AntoineGagnon/miryoku_zmk/temper-tps43-interposer/output/schematic.pdf

1 | 2 | 3 | 4 | 5 | 6
1 | 2 | 3 | 4 | 5 | 6

AB

C

D

AB

C

D Date:

Size: A4 | Rev: 1.0
KiCad E.D.A. 10.0.5 | Id: 1/1

### Title: Temper TPS43 Interposer

File: temper-tps43-interposer.kicad_sch

Sheet: /

nice!nano v2 pass-through with Azoteq TPS43 trackpad breakout

Nets: GND VCC SDA SCL RDY RST. All other Pro Micro pins pass through.

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
JP1 Pro Micro L | R2

2.2k R1
2.2k

# Mounting 1

2
3
4
5
6 MP

CON1

FFC 1x06 0.5mm

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
JP2 Pro Micro R | SCL VCC SDA VCC
RST | SDA GND | GND

RDY

VCC

## SDA GND

GND

SCL | SCL RDY

VCC

GND

RST JP1 / JP2 reproduce the nice!nano v2 (Pro Micro) footprint one for one. JP1.11 D8 / P1.04 -> SDA | JP2.12 D10 / P0.11 -> RDY
JP1.3, JP1.4, JP2.2 -> GND | JP2.4 | VCC (3.3V) | -> VCC
JP1.12 D9 / P0.09 -> SCL | JP2.11 D16 / P1.06 -> RST

tied to GND. B.Cu is a GND plane carrying the VCC, SCL-to-R2 and RST crossings.

straight-through cable instead, this board is wrong and must be re-fabbed.

Every pin not listed below is a bare pass-through: plated hole, no copper attached.

1:RDY 2:NRST 3:GND 4:VDDHI 5:SCL 6:SDA, so CON1 pin N carries TPS43 pin 7-N.

CON1 is wired as the MIRROR of the trackpad's own connector, because the FFC cable reverses the conductor order end to end. TPS43 J1 (datasheet rev 1.06, Aug 2025) is

R1/R2 are the 2.2k I2C bus pull-ups. CON1 MP is the pair of mechanical solder tabs,

VERIFY the cable before assembly: ring out pin 1 to pin 6 with a meter. If it is a
