AntoineGagnon/miryoku_zmk/temper-tps43-interposer/output/bottom.png

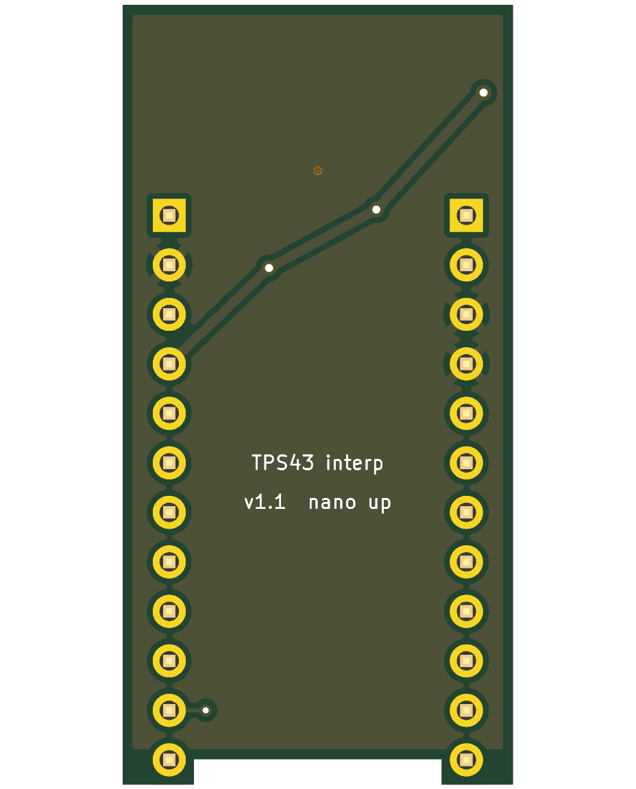
temper-tps43-interposer/output/bottom.png
