AntoineGagnon/miryoku_zmk/temper-tps43-interposer/output/top.png

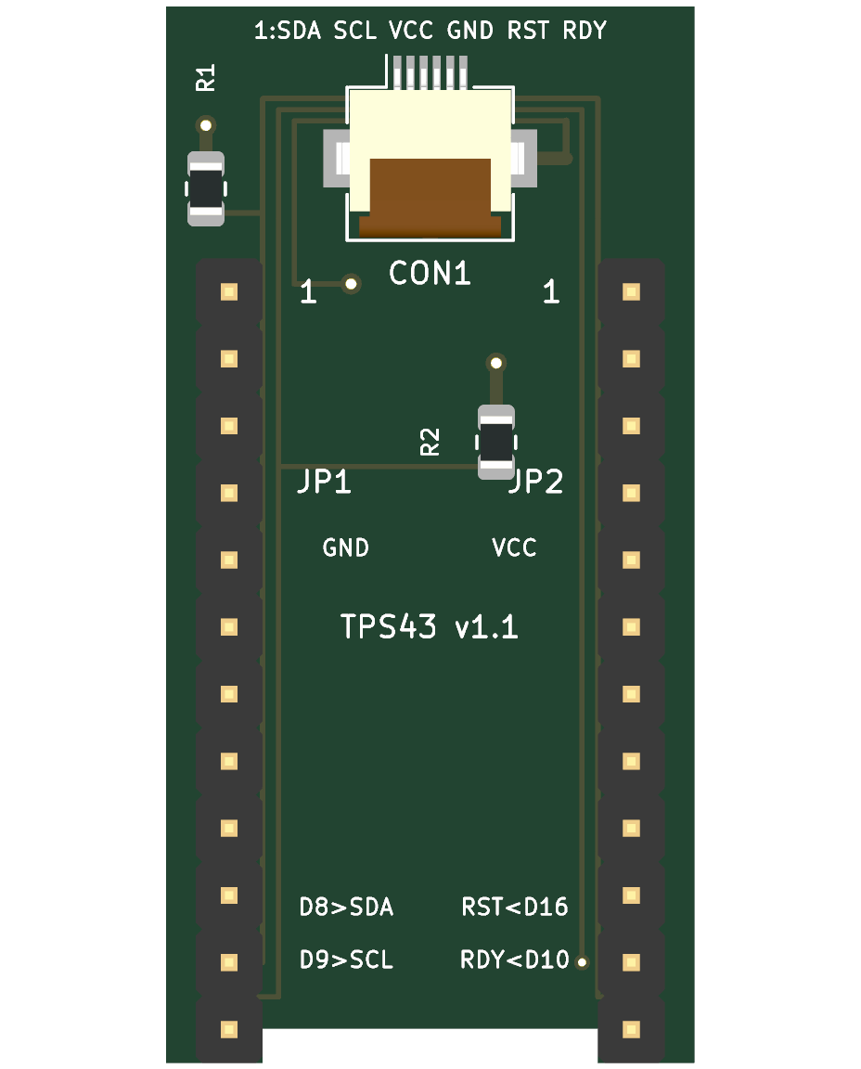
temper-tps43-interposer/output/top.png
