AntoineGagnon/miryoku_zmk/temper-tps43-interposer/temper-tps43-interposer.kicad_pcb

## KiCad design temper-tps43-interposer/temper-tps43-interposer.kicad_pcb (2026-08-06)

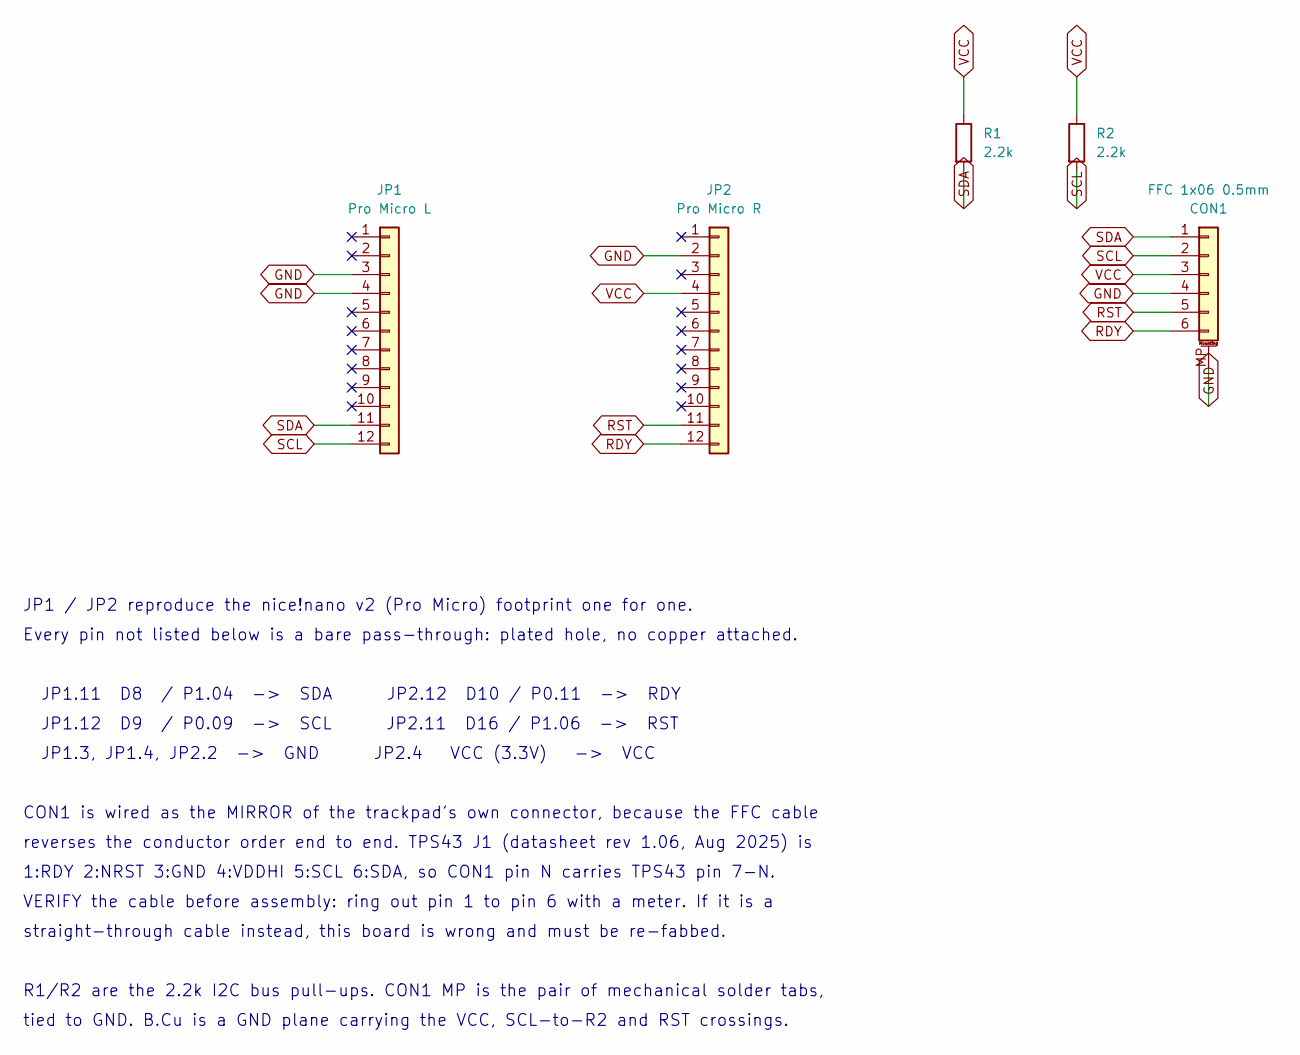
[picture p3: schematic temper-tps43-interposer.kicad_sch, Temper TPS43 Interposer]

Parts:
CON1: FFC 1x06 0.5mm; Hirose_FH12-6S-0.5SH_1x06-1MP_P0.50mm_Horizontal
JP1: Pro Micro L; PinHeader_1x12_P2.54mm_Vertical
JP2: Pro Micro R; PinHeader_1x12_P2.54mm_Vertical
R1, R2: 2.2k; R_0805_2012Metric

Connections:
GND: CON1.4, CON1.MP (MountPin), JP1.3, JP1.4, JP2.2
RDY: CON1.6, JP2.12
RST: CON1.5, JP2.11
SCL: CON1.2, JP1.12, R2.2
SDA: CON1.1, JP1.11, R1.2
VCC: CON1.3, JP2.4, R1.1, R2.1

Notes on the sheet:
JP1.12 D9 / P0.09 -> SCL JP2.11 D16 / P1.06 -> RST
VERIFY the cable before assembly: ring out pin 1 to pin 6 with a meter. If it is a
JP1.3, JP1.4, JP2.2 -> GND JP2.4 VCC (3.3V) -> VCC
R1/R2 are the 2.2k I2C bus pull-ups. CON1 MP is the pair of mechanical solder tabs,
JP1.11 D8 / P1.04 -> SDA JP2.12 D10 / P0.11 -> RDY
JP1 / JP2 reproduce the nice!nano v2 (Pro Micro) footprint one for one.
reverses the conductor order end to end. TPS43 J1 (datasheet rev 1.06, Aug 2025) is
CON1 is wired as the MIRROR of the trackpad's own connector, because the FFC cable
1:RDY 2:NRST 3:GND 4:VDDHI 5:SCL 6:SDA, so CON1 pin N carries TPS43 pin 7-N.
Every pin not listed below is a bare pass-through: plated hole, no copper attached.
straight-through cable instead, this board is wrong and must be re-fabbed.
tied to GND. B.Cu is a GND plane carrying the VCC, SCL-to-R2 and RST crossings.

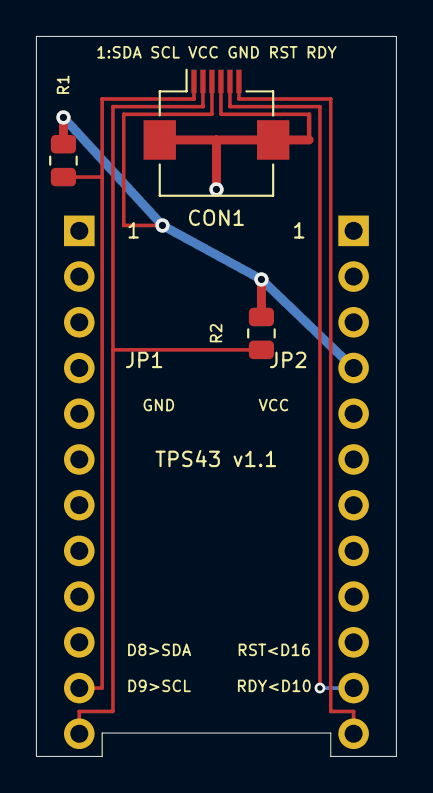
[picture p4: board temper-tps43-interposer.kicad_pcb from above]

Board: 2 copper layers, 20.0 x 40.0 mm, 5 parts (0 on the bottom side), 6 nets.
