AntoineGagnon/miryoku_zmk/(commit log)

2025-10-20 Move config to .github/actions-folders.json
    - Move from .github/workflows/actions-folders.yml to .github/actions-folders.json
    - Prevents GitHub Actions from treating config as workflow
    - Switch from YAML to JSON format for simpler parsing
2026-07-13 fix board name changes
2026-07-13 Fix board id and artifact name for ZMK Zephyr 4.1 board variants
    ZMK's move to Zephyr 4.1 HWMv2 requires an explicit zmk board variant
    (e.g. nice_nano//zmk instead of nice_nano or nice_nano_v2), otherwise
    shield board-overlays like nice_view_adapter's are silently skipped and
    the devicetree build fails on an undefined nice_view_spi label.
    The new board id contains slashes, which are invalid in artifact names,
    so sanitize them the same way spaces already are when building run_name.
2026-07-17 Add TPS43 trackpad interposer PCB for Temper keyboard
    - KiCAD 9 project with schematic and PCB layout
    - Custom footprint for Molex 503480-0600 FFC connector (6-pin, 0.5mm)
    - 24 pass-through Pro Micro pins + taps D8/D9/D10/D16 for TPS43
    - Pull-up resistors (2.2k) for SDA/SCL on I2C1 bus
    - Board outline 34x20mm, 1.0mm thickness, 2-layer
    - BOM.md with Digikey links (PCB route + breadboard route)
    - README with assembly instructions and ZMK firmware config
    [temper-tps43-interposer.kicad_pcb, temper-tps43-interposer.kicad_sch]
2026-07-17 Fix BOM: use digikey.ca links, fix FFC cable reference
    The FFC cable part number was wrong (0151660603 is a 152mm/50-pos part).
    Replaced with a Digikey filter link so you can pick any 6-pos 0.5mm
    Type A cable in the 50-150mm range. Updated all links to digikey.ca.
2026-07-17 BOM: fix male header and resistor digikey.ca links
    - Male header: Molex 0010897122 (actual 12-pos breakaway)
    - SMD resistor: Yageo RC0805FR-072K2P (confirmed on digikey.ca)
    - Female header: switched to filter link (many generic options work)
    - Added tip to buy 40-pin breakaway strips (cheaper per pin)
2026-07-17 BOM: use verified Molex 15018-0061 FFC cable part number
    15018-0061 = Premo-Flex 6-pos 0.5mm Type A (same-side) jumper, 152mm.
    Search this on digikey.ca. Any 6-pos 0.5mm Type A works.
2026-07-17 BOM: switch to shorter FFC cable 15018-0057, ~51mm
    51mm is plenty for routing from the interposer to a TPS43 in the thumb cluster.
    Also list longer fallbacks 15018-0065 and 15018-0061.
2026-07-17 BOM: use Assmann AFFC-050-06-051-11 FFC cable, confirmed on digikey.ca
    6 pos, 0.5mm, Type A, 51mm. Digikey PN AE11323-ND, ~$4 CAD, 365 in stock.
2026-07-17 BOM: fix TPS43 part number to TPS43-201A-S
2026-07-17 Rewrite PCB from scratch with proper library footprint references
    - Pin pads use Connector_PinHeader_2.54mm:PinHeader_1x01_P2.54mm_Vertical
    - Resistors use Resistor_SMD:R_0805_2012Metric
    - FFC connector uses our custom TPS43_FFC_06 footprint
    - All properties include proper layer, uuid, and effects blocks
    - Board outline 34x20mm, full layer set matching KiCAD 9 format
    - Fixed missing (layers) wrapper causing unbalanced parens
    - gen_pcb.py: reproducible generator, run to regenerate PCB
    [temper-tps43-interposer.kicad_pcb]
2026-07-17 Fix net references: add net name strings to pads and segments
    KiCAD 9 requires (net 1 "GND") not bare (net 1).
    Also added if __name__ guard to gen_pcb.py to prevent
    auto-regeneration on import.
    [temper-tps43-interposer.kicad_pcb]
2026-07-17 Fix segment format: use multi-line like API output
    KiCAD 9 requires (segment ...) sub-elements on separate lines.
    Single-line segments cause parser error at line 1087.
    [temper-tps43-interposer.kicad_pcb]
2026-07-17 Segments: use (net N) without name string, matching API format
    [temper-tps43-interposer.kicad_pcb]
2026-07-17 Fix board dimensions: 34x44mm, centered to encompass all components
    Board was 34x20mm - way too small. Components span from y=-17 to y=+22.
    Now 34x44mm with board Y centered at 1.5mm offset.
    Also fixed FFC connector pad Y to match custom footprint (1.0mm).
    [temper-tps43-interposer.kicad_pcb]
2026-07-17 Rewrite: use 1x12 pin headers (JP1, JP2), no auto-routed tracks
    - JP1 and JP2 are proper 12-pin headers with clean reference designators
    - FFC connector (CON1) and resistors (R1, R2) pre-placed
    - Nets pre-assigned on all pads
    - No crude auto-routed tracks — use KiCad interactive router instead
    - Board 34x44mm, properly sized for all components
    [temper-tps43-interposer.kicad_pcb]
2026-07-17 Rewrite schematic from scratch: clean KiCAD 9 format, standard symbols only
    - JP1, JP2: Connector_Generic:Conn_01x12
    - CON1: Connector_Generic:Conn_01x06
    - R1, R2: Device:R_Small
    - No custom symbol library references
    - All symbols defined inline in lib_symbols section
    [temper-tps43-interposer.kicad_sch]
2026-07-17 Remove manual pad geometry: let library footprints define pads
    pad() → pad_net() only sets net assignments.
    All pad positions, sizes, and layers come from the library footprints.
    Fixes resistors and FFC connector pads being mispositioned.
    [temper-tps43-interposer.kicad_pcb]
2026-08-06 Add comprehensive PCB design spec for another AI to use
    Every dimension, net, footprint, pinout, and placement written out
    explicitly. No ambiguity. Includes custom FFC footprint spec,
    BOM, assembly notes, and ZMK firmware reference.
2026-08-06 Rebuild TPS43 interposer from scratch for KiCad 10
    Replaces the hand-written KiCad 9 board with a generated one. gen_schematic.py
    owns the netlist table and gen_interposer.py imports it, so the schematic and
    the board cannot drift. build.sh gates on ERC, DRC and schematic parity, all of
    which are clean.
    Sized and verified against the actual Temper hardware (raeedcho/temper) rather
    than the old spec:
    - 20.0 x 40.0 mm, down from 34 x 44. Temper's choc hotswap sockets end 1.60 mm
    from the controller footprint, so the old width sat 6.44 mm over the adjacent
    switch column and overhung the right board edge by 6.76 mm.
    - Notched south edge to clear Temper's nice!view header J2, which starts l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
    [pos-front.csv, temper-tps43-interposer-B_Cu.gbl, temper-tps43-interposer-B_Mask.gbs, temper-tps43-interposer-B_Paste.gbp, temper-tps43-interposer-B_Silkscreen.gbo, temper-tps43-interposer-Edge_Cuts.gm1, temper-tps43-interposer-F_Cu.gtl, temper-tps43-interposer-F_Mask.gts]
2026-09-22 Add left thumb combos on Temper: Esc+Space -> F20, Space+Tab -> F21
2026-09-28 Fix thumb combo positions and use macOS-supported function keys
    Combo key-positions index the emitted bindings array (0-35), not the
    mapping macro's argument list (0-39). The N-prefixed args in
    MIRYOKU_LAYOUTMAPPING_MINIDOX are dropped from the expansion, so the
    thumb row starts at 30, not 32.
    Also drops F20/F21 for F14-F17. macOS defines no virtual keycode past
    F20, so F21 and up never reach applications.
    Esc+Space F14, Space+Tab F15, Enter+Bspc F16, Bspc+Del F17.
